bfarago/xmos_cpld_slice/doc/uppsc1.jpg

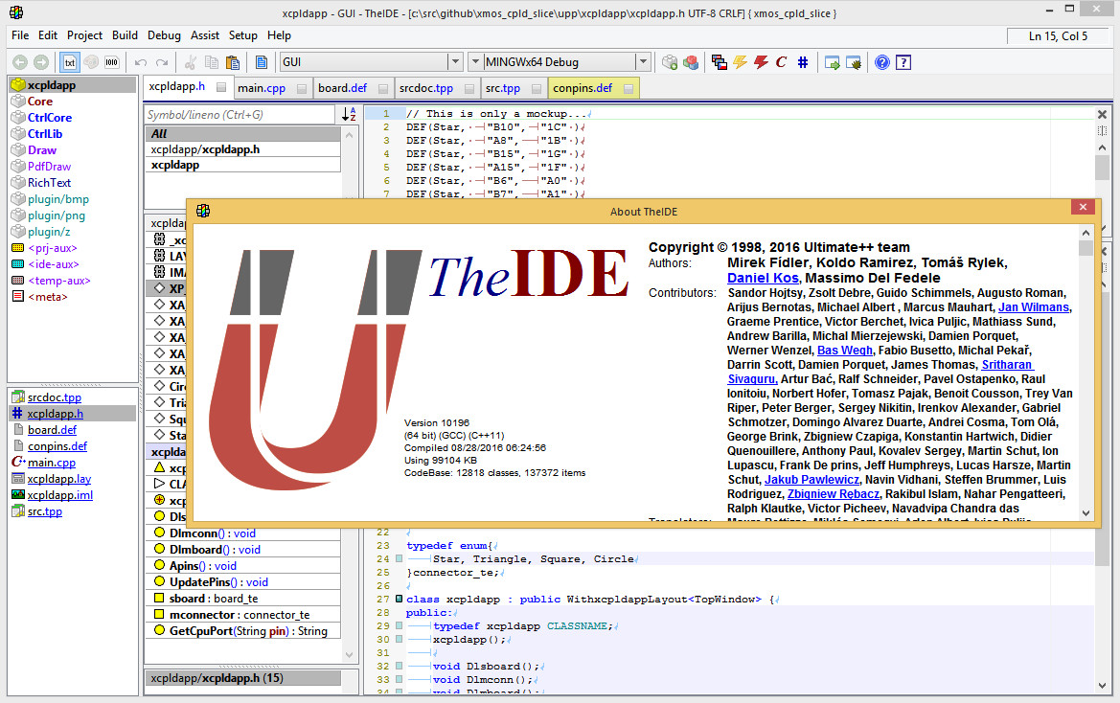
doc/uppsc1.jpg
