bfarago/xmos_cpld_slice/doc/app1.jpg

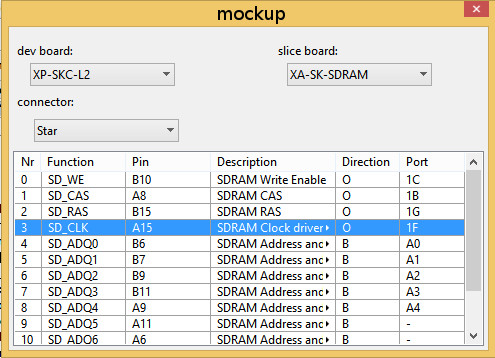
doc/app1.jpg
