bfarago/xmos_cpld_slice/README.md

# xmos_cpld_slice
This is a slice extender panel, which contains a small cpld, aimed to have configurable the bridge between the slot and the slice panel.

[The page of the project](https://bfarago.github.io/xmos_cpld_slice/)
