bfarago/xmos_cpld_slice/doc/alterasc1.jpg

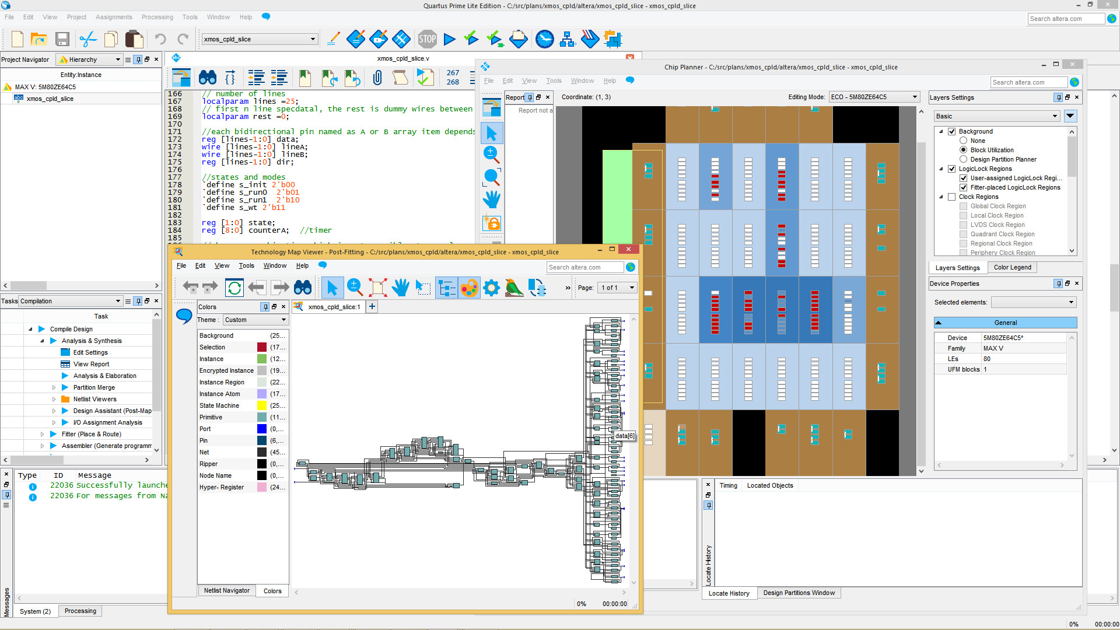
doc/alterasc1.jpg
