bfarago/xmos_cpld_slice/doc/kicadsc1.jpg

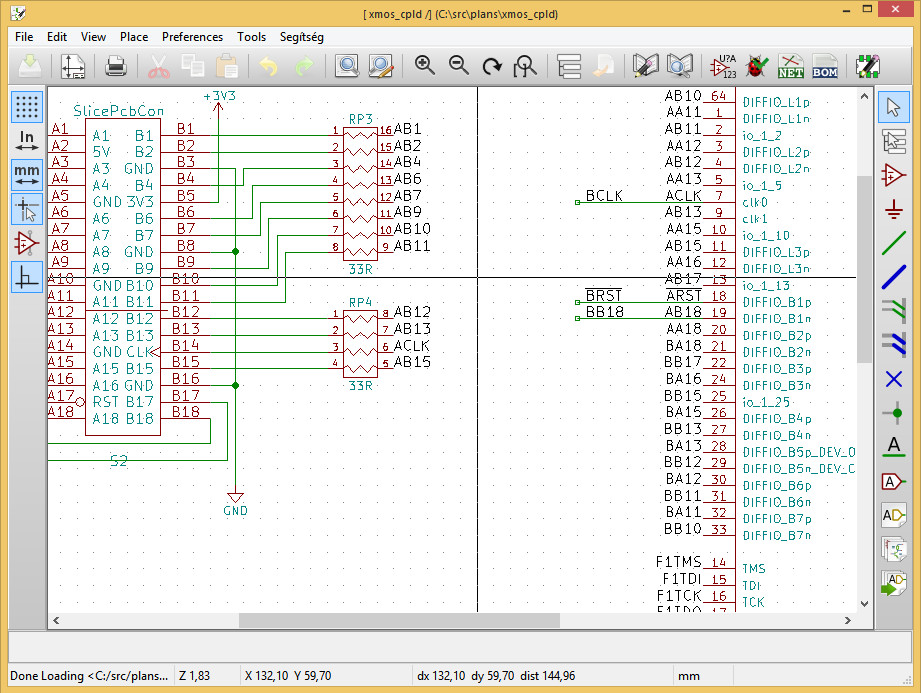
doc/kicadsc1.jpg
