bfarago/xmos_cpld_slice/doc/xmos_cpld2.jpg

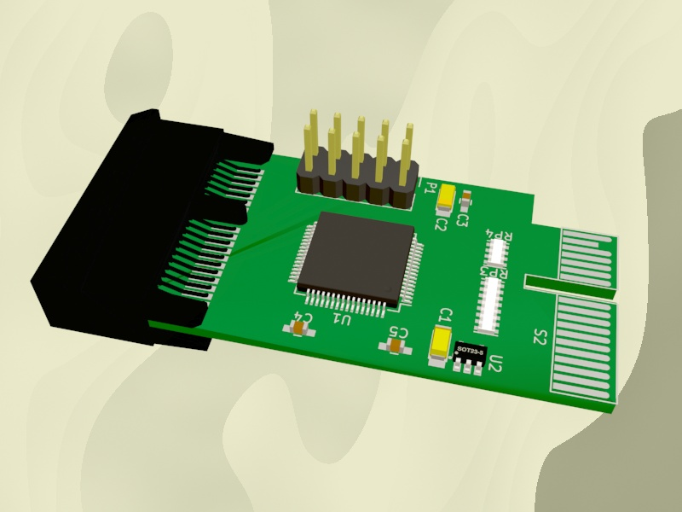
doc/xmos_cpld2.jpg
