bfarago/xmos_cpld_slice/doc/pcb_xmos_cpld_slice_v1.pdf

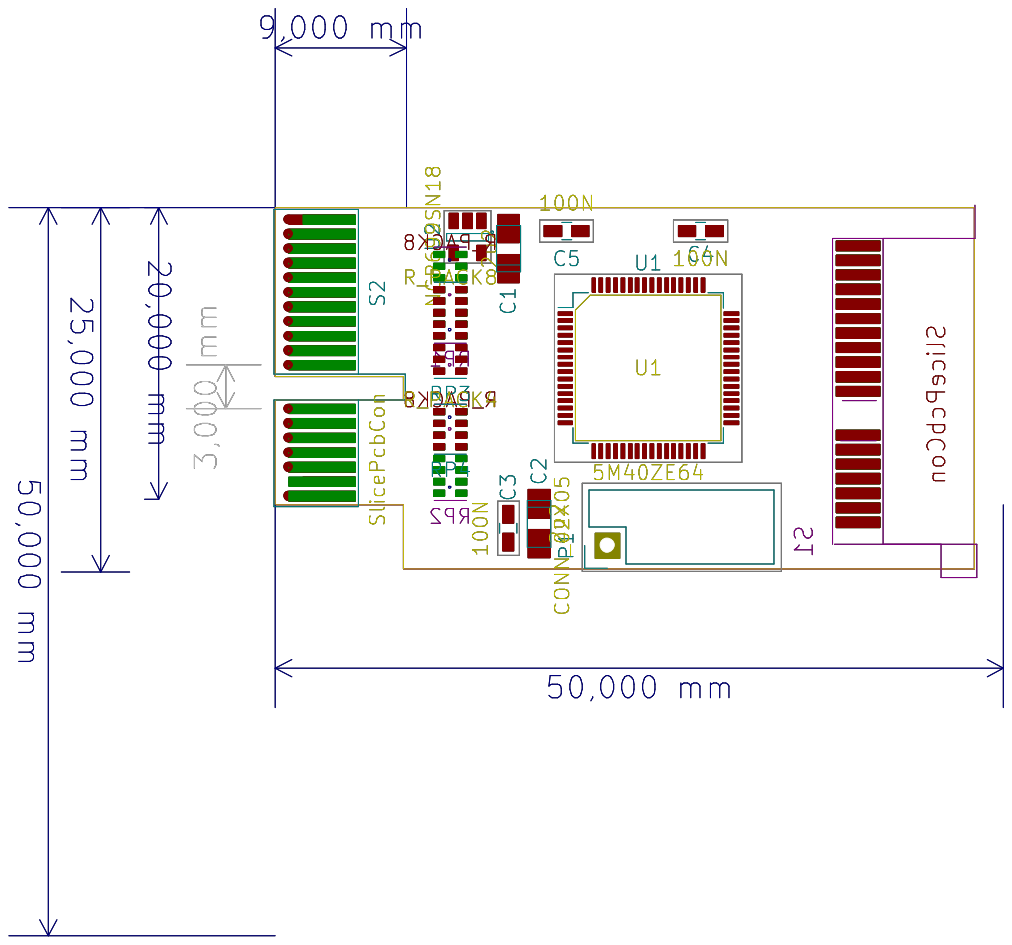
[picture p6: page 1]
