bfarago/xmos_cpld_slice/doc/rtlview.pdf

## myiobufA23

## MAXV_IO

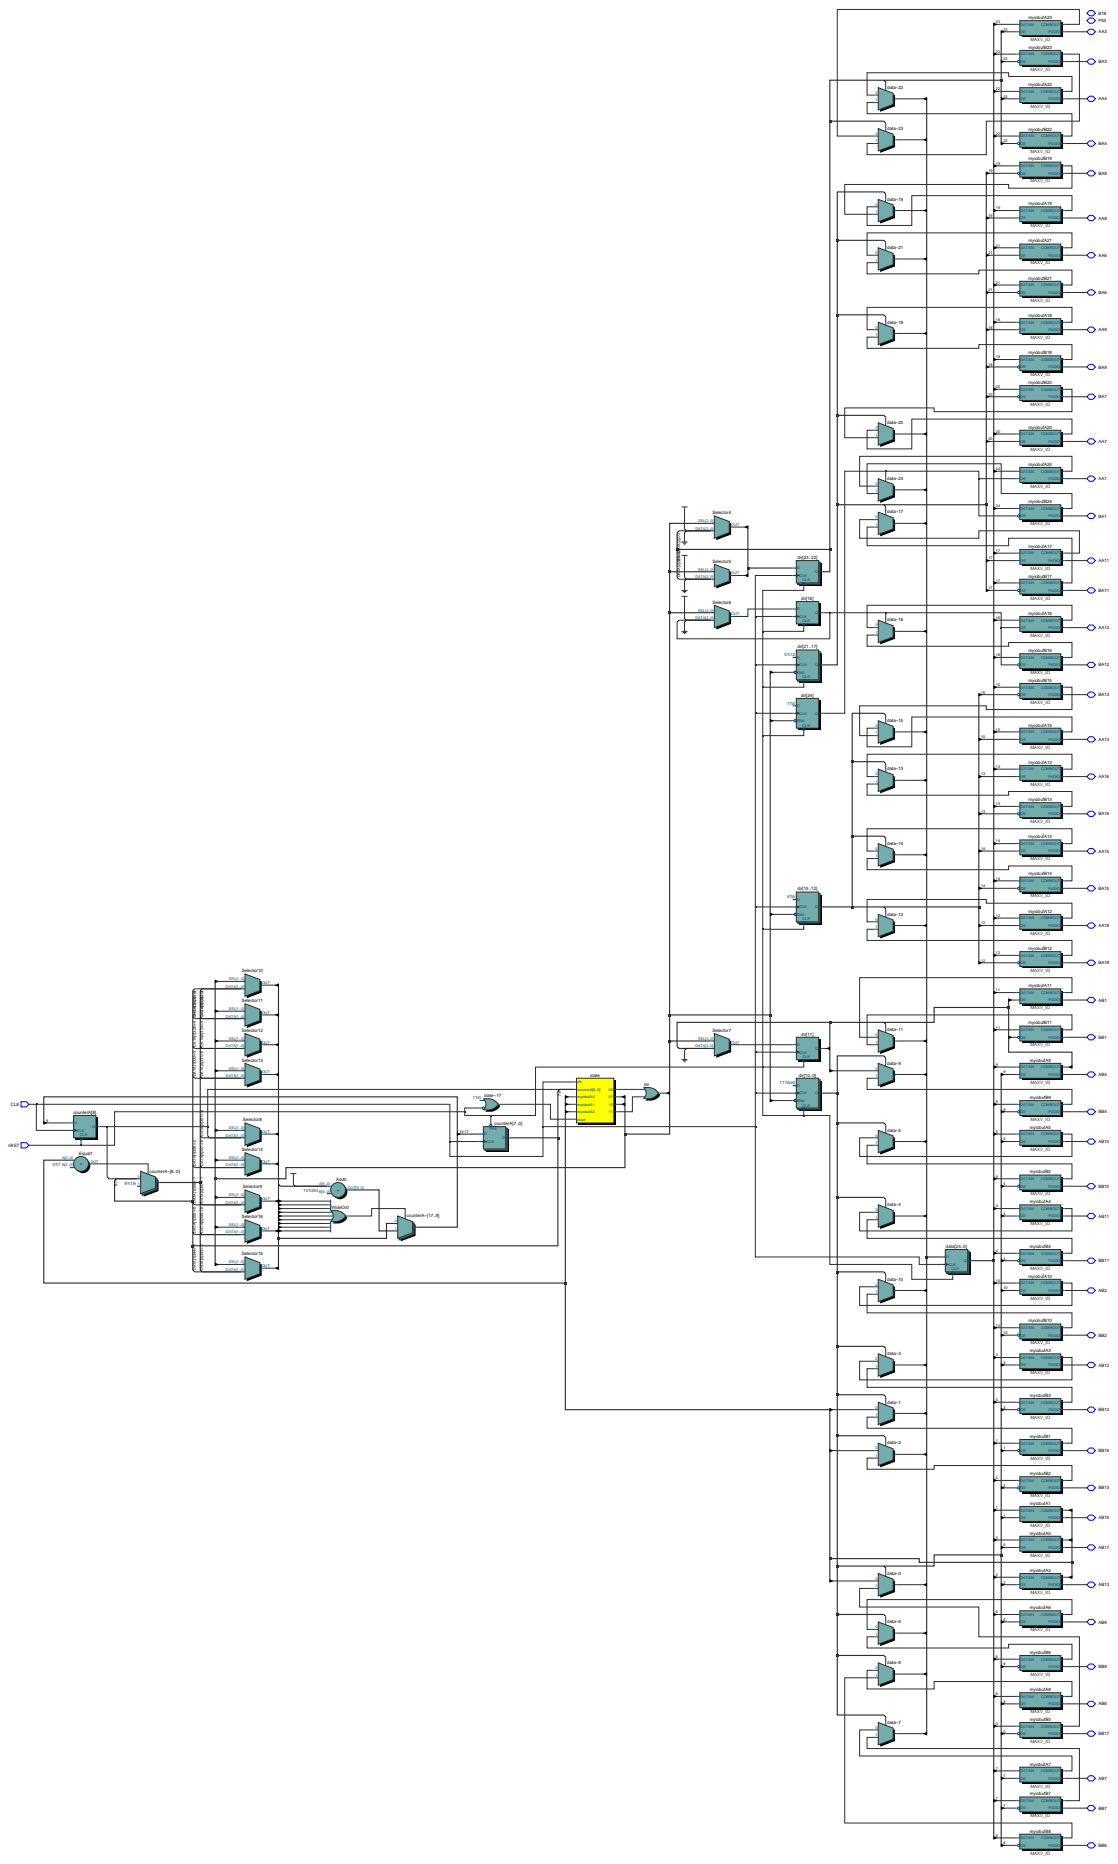
[picture p7: page 1]
DATAIN OE; COMBOUT PADIO; AA3 myiobufB23; MAXV_IO; myiobufA22; data~22 01; data~23 01; myiobufB22; BA4 myiobufB19; data~19 01; myiobufA19; myiobufA21; data~21 01; myiobufB21; myiobufA18; data~18 01; myiobufB18; BA9 myiobufB20; data~20 01; myiobufA20; myiobufA24; COMBOUT data~24; PADIO; myiobufB24; BA1 Selector4; SEL[2..0] DATA[2..0]; OUT; data~17 01; dir[23..22] D; CLKCLR; myiobufA17; COMBOUT Selector5; myiobufB17; COMBOUT PADIO Selector6; dir[16] D; dir[21..17] D; 5'h12 CLKCLR; ENA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

data[24..0] D CLKCLR Q | 10
