bfarago/xmos_cpld_slice/doc/sch_xmos_cpld_slice_v1.pdf

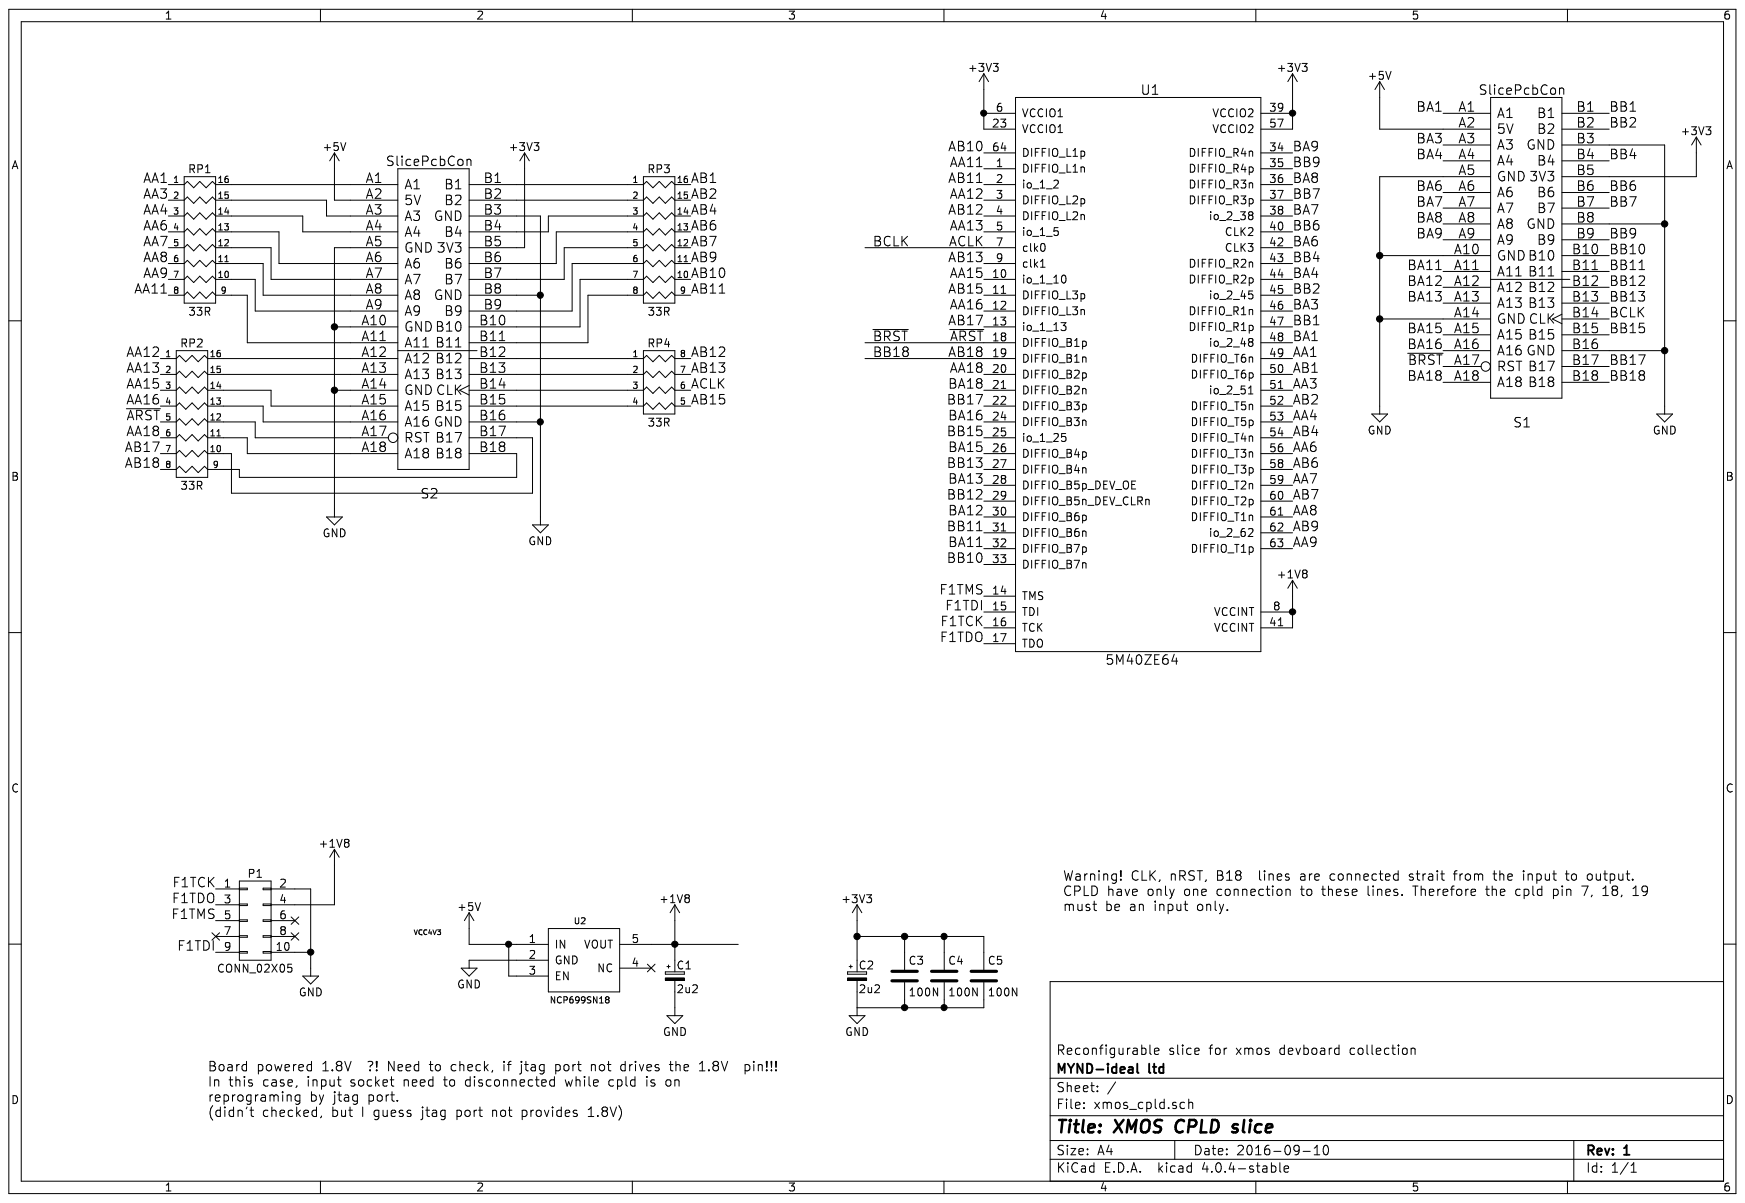
[picture p8: page 1]
