bfarago/xmos_cpld_slice/(list of files, drawings)

Other design files:
upp/xcpldapp/xcpldapp.lay
