bfarago/xmos_cpld_slice/kicad/xmos_cpld.kicad_pcb

## KiCad design kicad/xmos_cpld.kicad_pcb (2016-09-12)

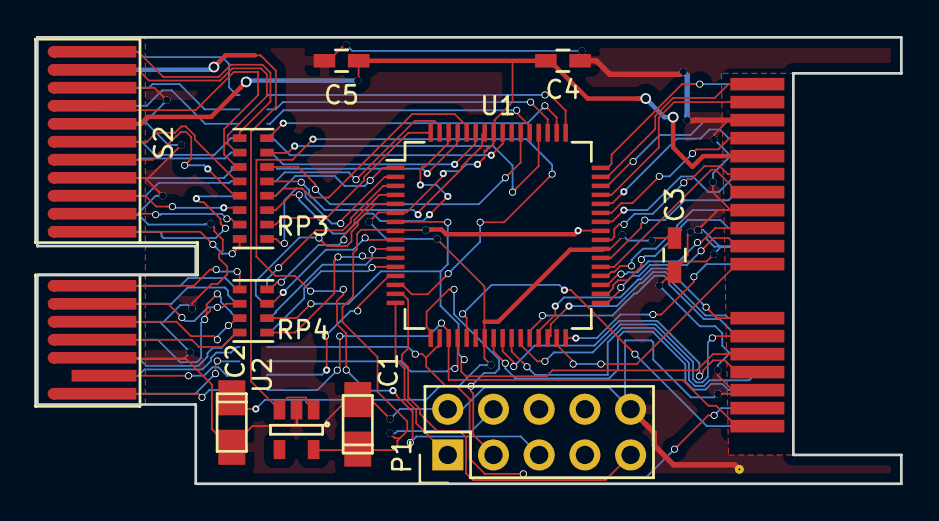
[picture p9: board xmos_cpld.kicad_pcb from above]

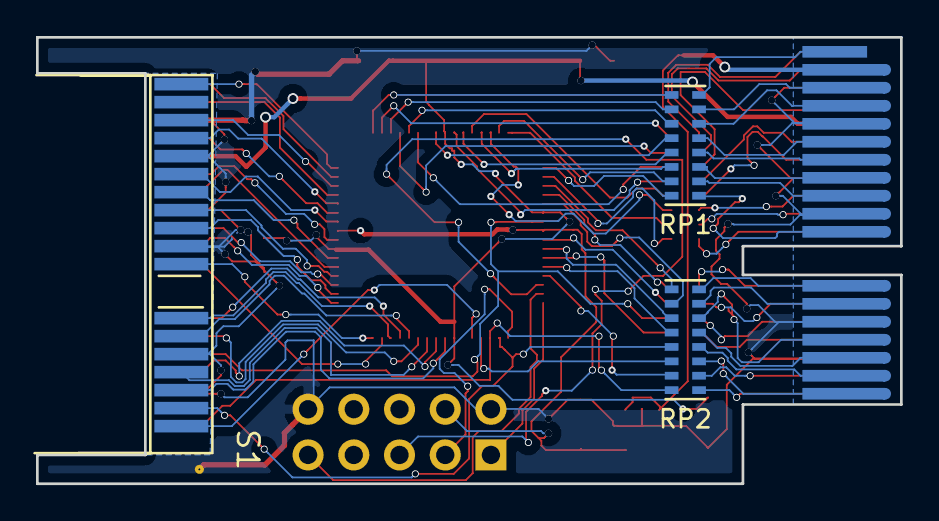
[picture p10: board xmos_cpld.kicad_pcb from below]

Board: 2 copper layers, 48.0 x 24.8 mm, 15 parts (3 on the bottom side), 90 nets.

Parts:
C1, C2: 2u2; TantalC_SizeS_EIA-3216
C3, C4, C5: 100N; C_0603_HandSoldering
P1: CONN_02X05; Pin_Header_Straight_2x05
P16: Pillar
RP1, RP2, RP3: 33R; R_Cat16-8
RP4: 33R; R_Cat16-4
S1: SlicePcbCon; PCIe_36
S2: SlicePcbCon; PCI-EXPRESS
U1: 5M40ZE64; LQFP-64_10x10mm_Pitch0.5mm
U2: NCP699SN18; SOT-23-5

Connections:
+1V8: C1.1, P1.4, U1.8, U1.41, U2.5
+3V3: C2.1, C3.1, C4.1, C5.1, S1.B5, S2.B5, U1.6, U1.23, U1.39, U1.57
+5V: S1.A2, S2.A2, U2.1, U2.3
/AA1: RP1.1, U1.49
/AA3: RP1.2, U1.51
/AA4: RP1.3, U1.53
/AA6: RP1.4, U1.56
/AA7: RP1.5, U1.59
/AA8: RP1.6, U1.61
/AA9: RP1.7, U1.63
/AA11: RP1.8, U1.1
/AA12: RP2.1, U1.3
/AA13: RP2.2, U1.5
/AA15: RP2.3, U1.10
/AA16: RP2.4, U1.12
/AA18: RP2.6, U1.55
/AB1: RP3.16, U1.50
/AB2: RP3.15, U1.52
/AB4: RP3.14, U1.54
/AB6: RP3.13, U1.58
/AB7: RP3.12, U1.60
/AB9: RP3.11, U1.62
/AB10: RP3.10, U1.64
/AB11: RP3.9, U1.2
/AB12: RP4.8, U1.4
/AB13: RP4.7, U1.9
/AB15: RP4.5, U1.11
/AB17: RP2.7, U1.13
/AB18: RP2.8, U1.19
/ACLK: RP4.6, S1.B14, U1.7
/BA1: S1.A1, U1.48
/BA3: S1.A3, U1.46
/BA4: S1.A4, U1.44
/BA6: S1.A6, U1.42
/BA7: S1.A7, U1.38
/BA8: S1.A8, U1.36
/BA9: S1.A9, U1.34
/BA11: S1.A11, U1.32
/BA12: S1.A12, U1.30
/BA13: S1.A13, U1.28
/BA15: S1.A15, U1.26
/BA16: S1.A16, U1.24
/BA18: S1.A18, U1.21
/BB1: S1.B1, U1.47
/BB2: S1.B2, U1.45
/BB4: S1.B4, U1.43
/BB6: S1.B6, U1.40
/BB7: S1.B7, U1.37
/BB9: S1.B9, U1.35
/BB10: S1.B10, U1.33
/BB11: S1.B11, U1.31
/BB12: S1.B12, U1.29
/BB13: S1.B13, U1.27
/BB15: S1.B15, U1.25
/BB17: S1.B17, U1.22
/BB18: S1.B18, U1.20
/F1TCK: P1.1, U1.16
/F1TDI: P1.9, U1.15
/F1TDO: P1.3, U1.17
/F1TMS: P1.5, U1.14
/~ARST: RP2.5, S1.A17, U1.18
GND: C1.2, C2.2, C3.2, C4.2, C5.2, P1.2, P1.10, P16.1, S1.A5, S1.A10, S1.A14, S1.B3, S1.B8, S1.B16, S2.A5, S2.A10, S2.A14, S2.B3, S2.B8, S2.B16, U2.2
unnamed: RP1.9, S2.A11
unnamed: RP1.10, S2.A9
unnamed: RP1.11, S2.A8
unnamed: RP1.12, S2.A7
unnamed: RP1.13, S2.A6
unnamed: RP1.14, S2.A4
unnamed: RP1.15, S2.A3
unnamed: RP1.16, S2.A1
unnamed: RP2.9, S2.B18
unnamed: RP2.10, S2.B17
unnamed: RP2.11, S2.A18
unnamed: RP2.12, S2.A17
unnamed: RP2.13, S2.A16
unnamed: RP2.14, S2.A15
unnamed: RP2.15, S2.A13
unnamed: RP2.16, S2.A12
unnamed: RP3.1, S2.B1
unnamed: RP3.2, S2.B2
unnamed: RP3.3, S2.B4
unnamed: RP3.4, S2.B6
unnamed: RP3.5, S2.B7
unnamed: RP3.6, S2.B9
unnamed: RP3.7, S2.B10
unnamed: RP3.8, S2.B11
unnamed: RP4.1, S2.B12
unnamed: RP4.2, S2.B13
unnamed: RP4.3, S2.B14
unnamed: RP4.4, S2.B15
