bfarago/xmos_cpld_slice/(commit log)

2016-09-11 kicad project added
    [xmos_cpld.kicad_pcb, xmos_cpld.sch]
2016-09-11 ultimate++ desktop app added
    [xcpldapp.lay]
2016-09-11 verilog gen, screensh.
    [xcpldapp.lay]
2016-09-12 1V8 pwr chip goes to other edge of the board. GND zones added.
    [xmos_cpld.kicad_pcb]
2016-09-12 add p55, gnd.
    [xmos_cpld.kicad_pcb, xmos_cpld.sch]
2016-09-14 add xpin verilog, qsf export. More pin descriptions.
2016-09-15 GPIO board added
2016-09-16 several boards added
